PtSamuel/PrismRanger-Perception-Mast/MDD/assembly.SLDASM

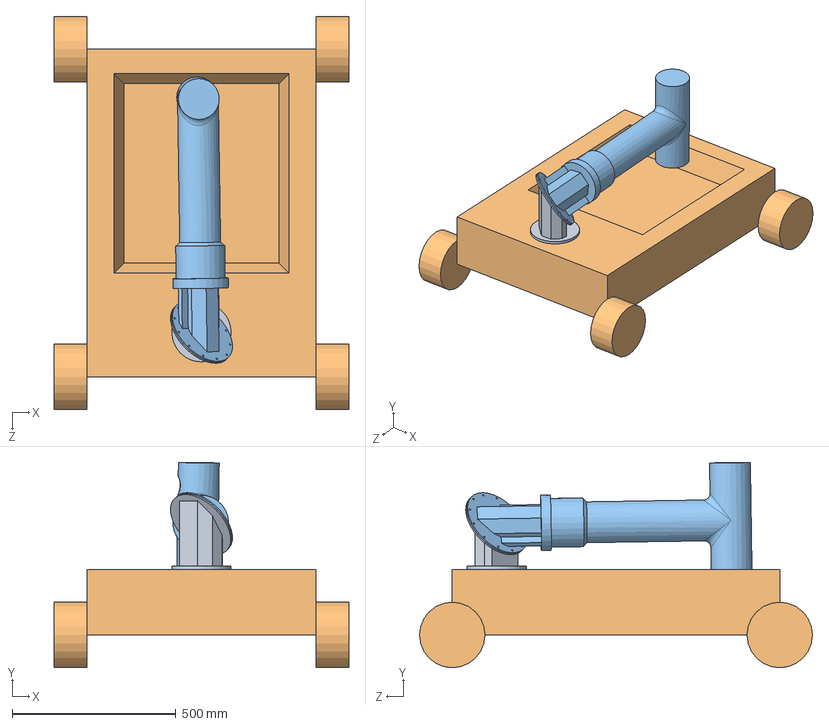
[picture p23: CAD file, 2022-10-14]
MDD/assembly.SLDASM
900.0 x 627.3 x 1200.0 mm
MDD
Rover
Mast
