PtSamuel/PrismRanger-Perception-Mast/MDD/Rover.SLDPRT

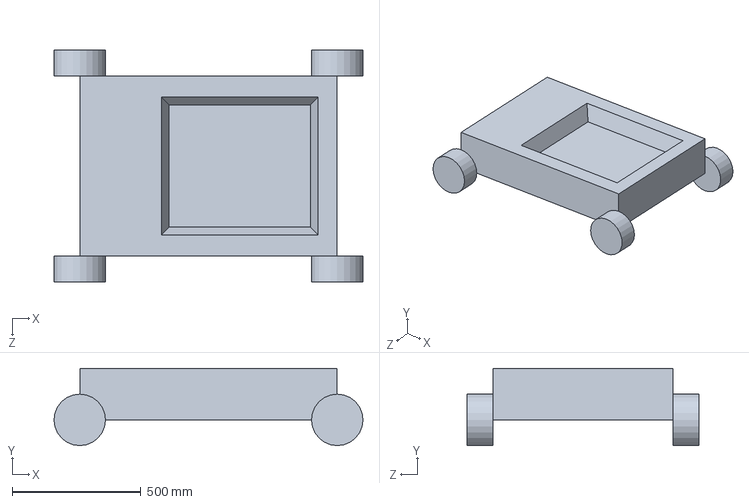
[picture p24: CAD file, 2022-10-14]
MDD/Rover.SLDPRT
1200.0 x 300.0 x 900.0 mm
