PtSamuel/PrismRanger-Perception-Mast/MDD/MDD.SLDPRT

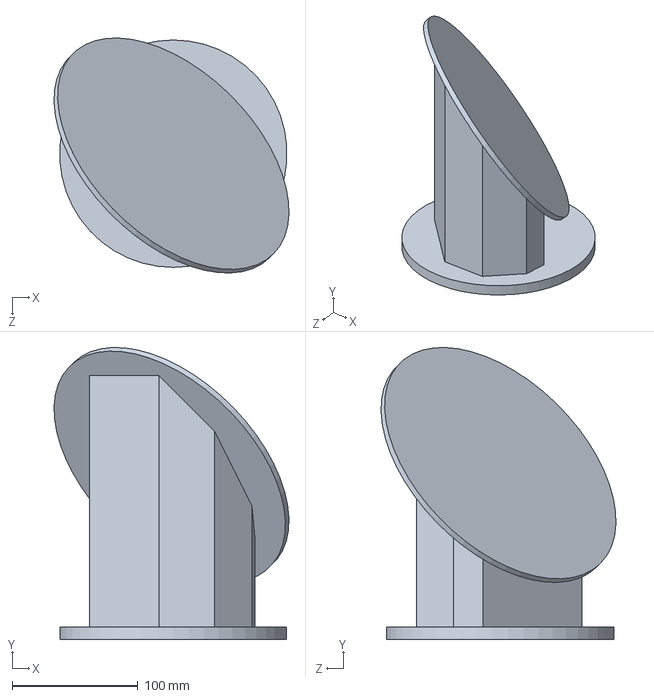
[picture p25: CAD file, 2022-10-14]
MDD/MDD.SLDPRT
186.5 x 231.8 x 186.5 mm
