PtSamuel/PrismRanger-Perception-Mast/MDD/Mast.SLDPRT

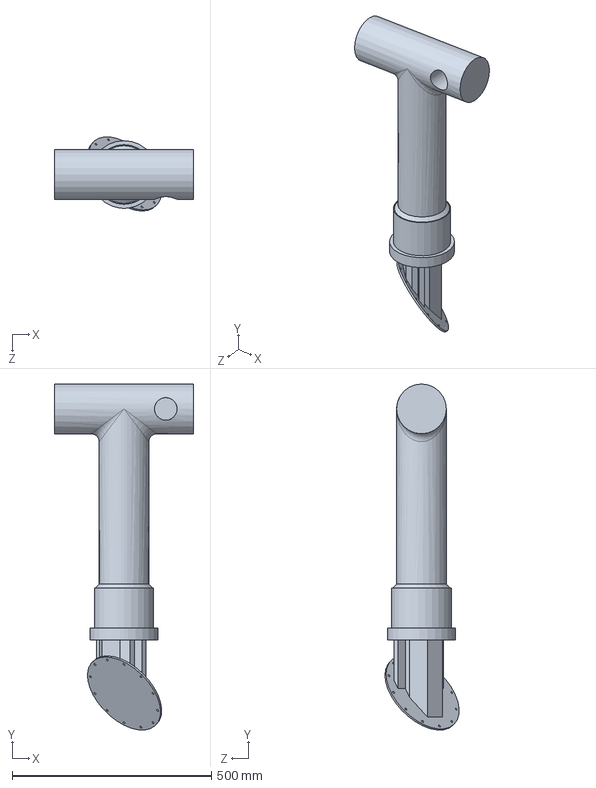
[picture p26: CAD file, 2022-10-14]
MDD/Mast.SLDPRT
350.0 x 869.0 x 186.3 mm
